AndreiXYZ/ProiectArduino/README.md

# ProiectArduino
Project for Arduino class
