AndreiXYZ/ProiectArduino/(list of files, drawings)

Other design files:
Kinesis.fzz
